flinthillsradio/PowerPanel/README.md

# PowerPanel
Master branch: Arduino Pro-Micro based Solar Controller Plus PwrGate for LiFePO4 4s battery 14v (CC/CV/Off)
 SLA branch: modified for lead acid batteries (CC/CV/Float)

The power panel is a project designed for Novexcomm for use in rack mounted Go-Kits as well as fixed station power.
The PP provides backup battery power for 12-14v systems with charging from station power supply or Solar (12 or 24v) panels.
Contact Novexcomm at www.shackinthebox.com for pricing and availability.

Board and firmware designed by Jim Cordill KI0BK Flint Hills Radio Inc www.flinthillsradioinc.com
Suggestions and inprovements welcome.
