flinthillsradio/PowerPanel/LLPP.pdf

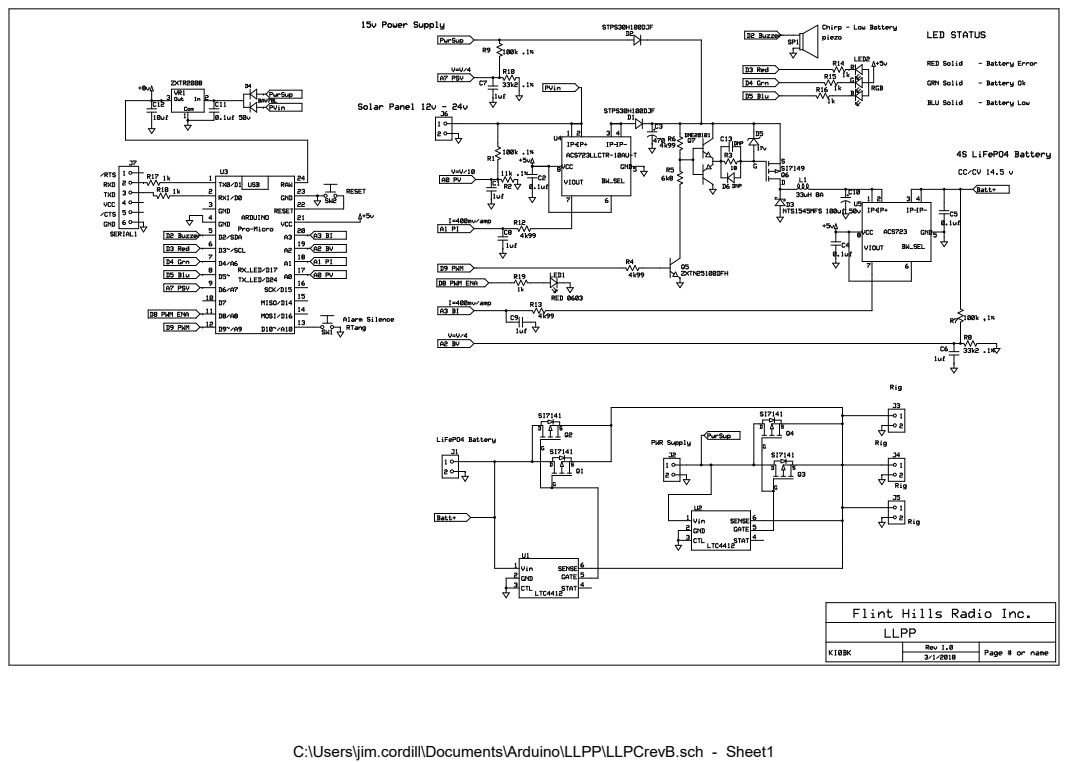
[picture p1: page 1]

C:\Users\jim.cordill\Documents\Arduino\LLPP\LLPCrevB.sch - Sheet1
