flinthillsradio/PowerPanel/(commit log)

2018-03-12 Update LLPP.ino
    Fixed Buzzer output
    [LLPP.ino]
2018-03-14 Set Low Battery alarm to 12.4v,fixed buzzer port to be outputs
    [LLPP.ino]
2018-04-12 Version 1.0 release for first two pcbs for Novexcomm
2018-04-12 Added a copy of needed library TimerOne (copy to library folder)
2018-04-12 Schematic rev B3
2018-06-20 Added factory setup for two sizes of lifepo4 packs 12ah and 20ah changes charging rate
